itzzhashtag/Universal-Radio-Control-IOT-ESP/(list of files, drawings)

Other design files:
Code [Upload]-GitHub/ESP_Controller_Tx_v0.4.2 [Basic]/ESP_Controller_v0.9.1/ESP_Controller_Rx_v0.9.1/paul_line_follower.fzz
Code [Upload]-GitHub/ESP_Controller_Tx_v0.4.2 [Basic]/ESP_Controller_v0.9.2/ESP_Controller_Rx_v0.9.2/ESP_Controller_Rx_v0.9.2.fzz
Code [Upload]-GitHub/ESP_Controller_Tx_v0.4.2 [Basic]/ESP_Controller_v0.9.2/Robo_Car_Rx.fzz
Code [Upload]-GitHub/ESP_Controller_Tx_v0.4.2 [Basic]/ESP_Controller_v0.9.3 [Current]/ESP_Controller_Rx_v0.9.3/ESP_Controller_Rx_v0.9.3.fzz
Code [Upload]-GitHub/ESP_Controller_Tx_v0.4.2 [Basic]/ESP_Controller_v0.9.3 [Current]/ESP_Controller_Tx_v0.9.3/ESP_Controller_Tx_v0.9.3.fzz
Code [Upload]-GitHub/ESP_Controller_v2.0[Curent URC]/URC_v2.0.fzz
